sublimatedware/ILDA-Spec-Laser-Projector--Legacy-/Picture of Entire System.jpg

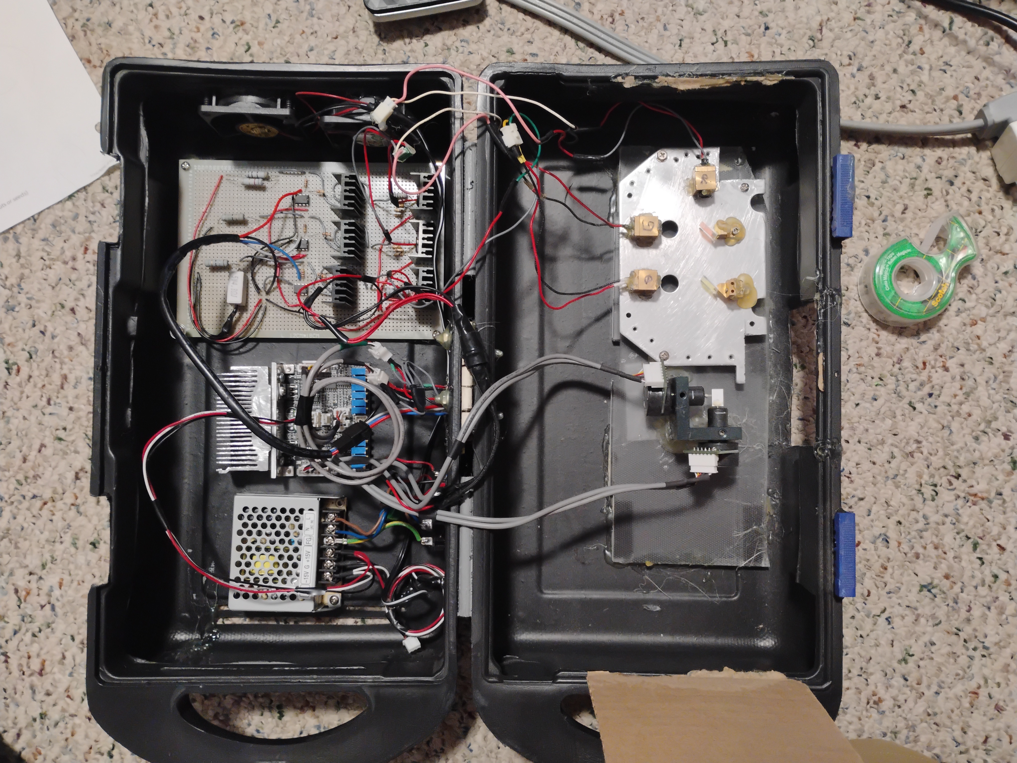
Picture of Entire System.jpg
