sublimatedware/ILDA-Spec-Laser-Projector--Legacy-/Demonstration Media/Deer.jpg

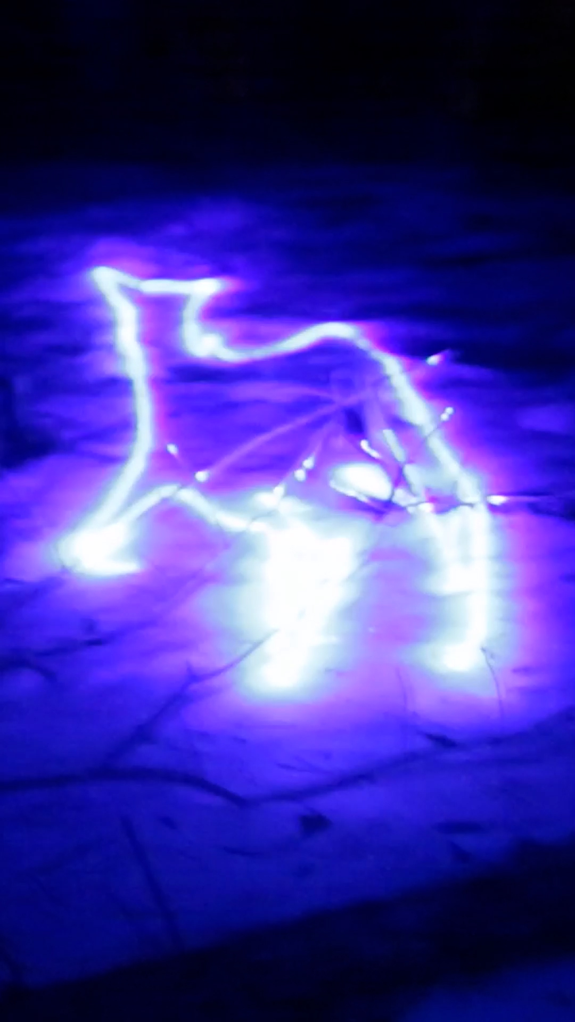
Demonstration Media/Deer.jpg
