sublimatedware/ILDA-Spec-Laser-Projector--Legacy-/Demonstration Media/IIlluminating DJ.jpg

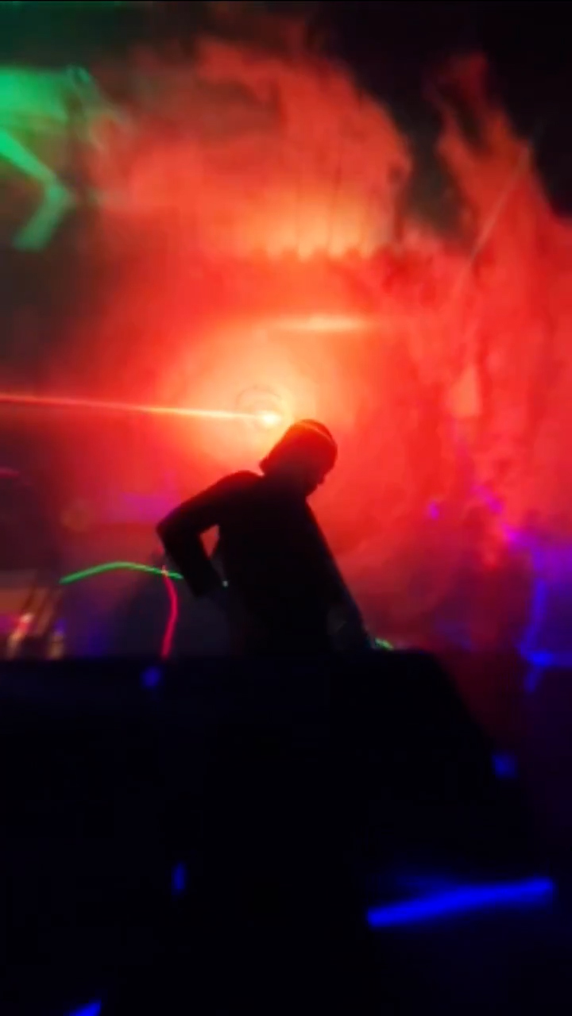
Demonstration Media/IIlluminating DJ.jpg
