sublimatedware/ILDA-Spec-Laser-Projector--Legacy-/Demonstration Media/Immersion in Light.jpg

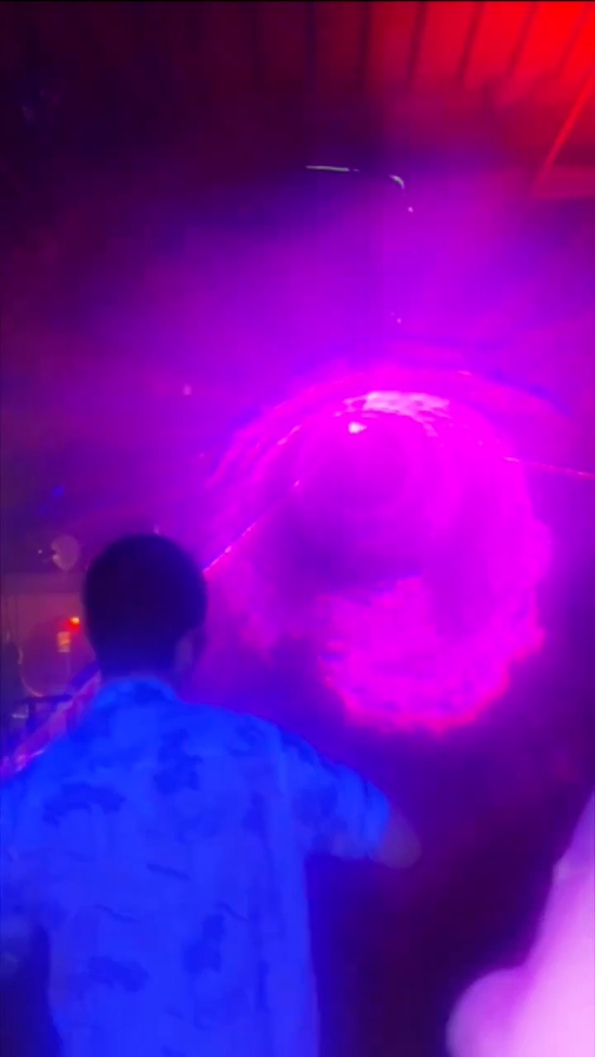
Demonstration Media/Immersion in Light.jpg
