sublimatedware/ILDA-Spec-Laser-Projector--Legacy-/Demonstration Media/Laser at Party 2.jpg

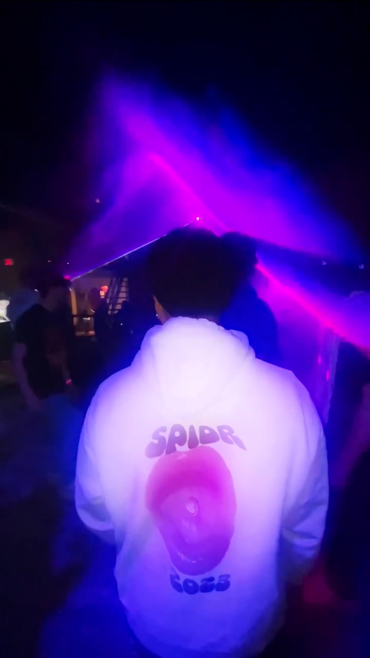
Demonstration Media/Laser at Party 2.jpg
