sublimatedware/ILDA-Spec-Laser-Projector--Legacy-/Demonstration Media/Laser at Party.jpg

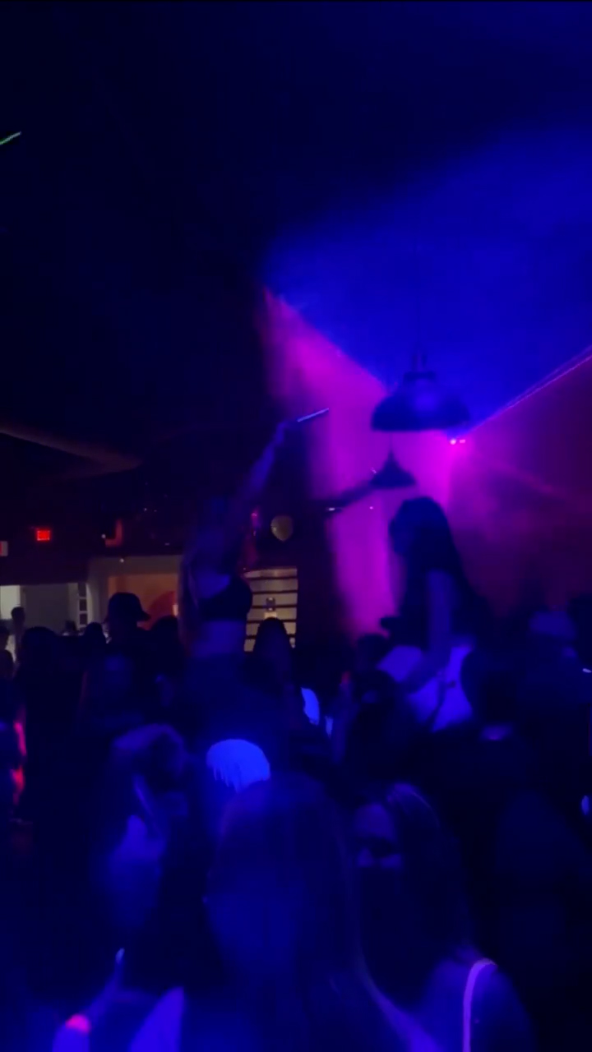
Demonstration Media/Laser at Party.jpg
