sublimatedware/ILDA-Spec-Laser-Projector--Legacy-/Retroactive schematic.png

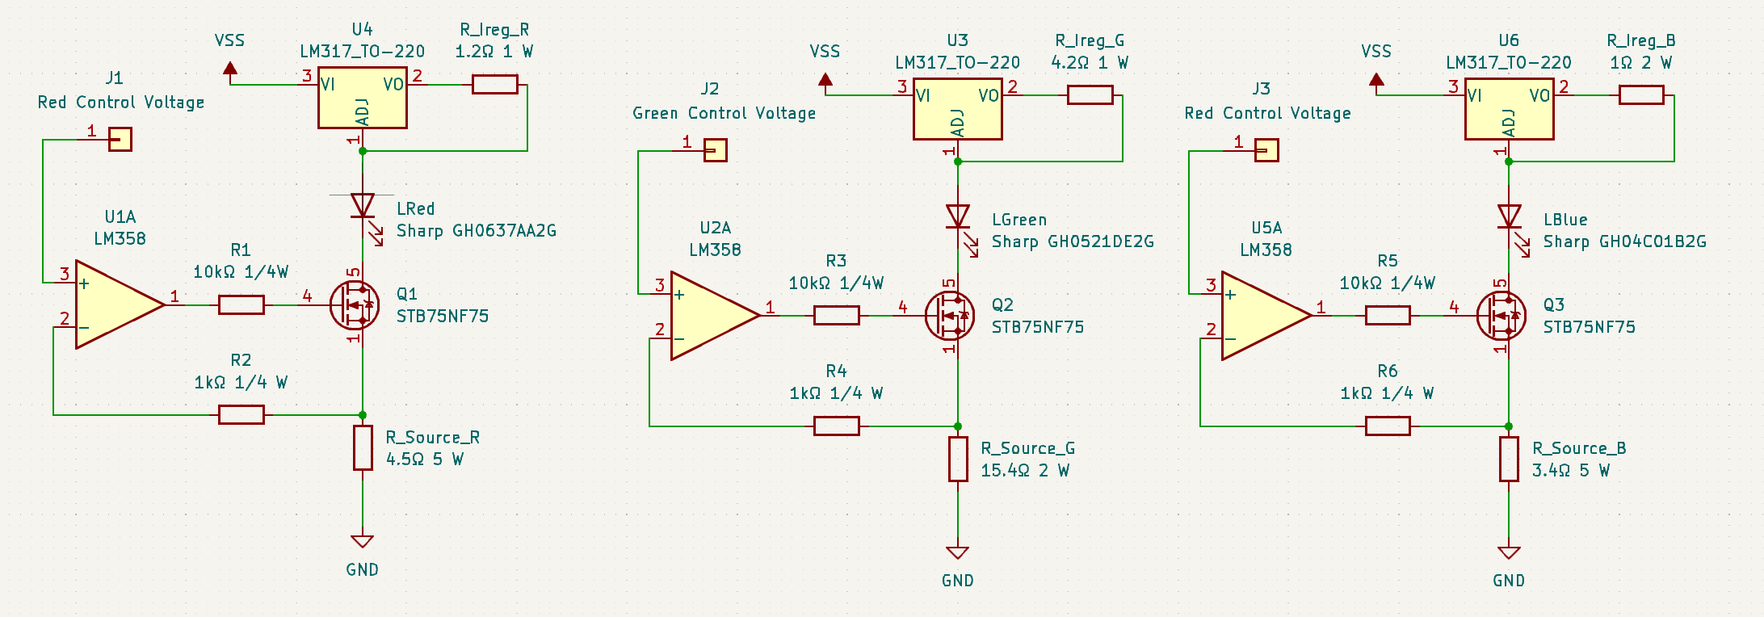
Retroactive schematic.png
