sublimatedware/ILDA-Spec-Laser-Projector--Legacy-/retroactive schematic.kicad_sch

## KiCad design retroactive schematic.kicad_sch (2026-03-03)

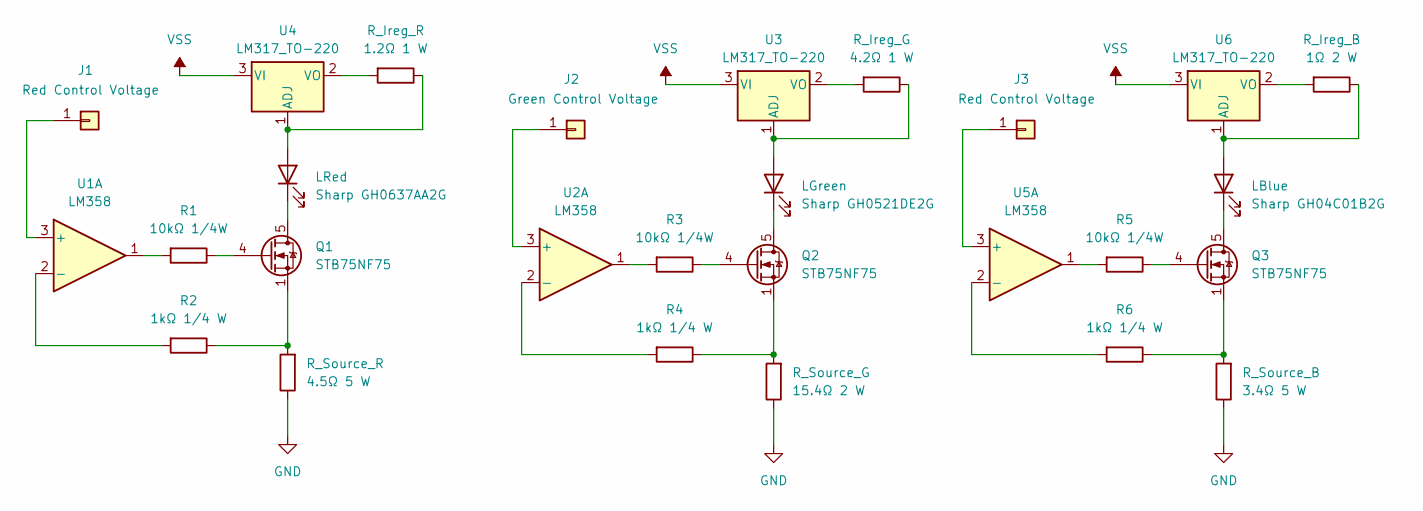
[picture p8: schematic retroactive schematic.kicad_sch]

Parts:
J1, J3: Red Control Voltage
J2: Green Control Voltage
LBlue: Sharp GH04C01B2G
LGreen: Sharp GH0521DE2G
LRed: Sharp GH0637AA2G
Q1, Q2, Q3: STB75NF75; TDSON-8-1
R1, R3, R5: 10kΩ 1/4W
R2, R4, R6: 1kΩ 1/4 W
R_Ireg_B: 1Ω 2 W
R_Ireg_G: 4.2Ω 1 W
R_Ireg_R: 1.2Ω 1 W
R_Source_B: 3.4Ω 5 W
R_Source_G: 15.4Ω 2 W
R_Source_R: 4.5Ω 5 W
U1, U2, U5: LM358
U3, U4, U6: LM317_TO-220; TO-220-3_Vertical

Connections:
GND: R_Source_B.1, R_Source_G.1, R_Source_R.1
unnamed: J1.1, U1.3 (+)
unnamed: J2.1, U2.3 (+)
unnamed: J3.1, U5.3 (+)
unnamed: LBlue.1 (K), Q3.5 (D)
unnamed: LBlue.2 (A), R_Ireg_B.1, U6.1 (ADJ)
unnamed: LGreen.1 (K), Q2.5 (D)
unnamed: LGreen.2 (A), R_Ireg_G.1, U3.1 (ADJ)
unnamed: LRed.1 (K), Q1.5 (D)
unnamed: LRed.2 (A), R_Ireg_R.1, U4.1 (ADJ)
unnamed: Q1.1 (S), Q1.2 (S), Q1.3 (S), R2.1, R_Source_R.2
unnamed: Q1.4 (G), R1.1
unnamed: Q2.1 (S), Q2.2 (S), Q2.3 (S), R4.1, R_Source_G.2
unnamed: Q2.4 (G), R3.1
unnamed: Q3.1 (S), Q3.2 (S), Q3.3 (S), R6.1, R_Source_B.2
unnamed: Q3.4 (G), R5.1
unnamed: R1.2, U1.1
unnamed: R2.2, U1.2 (-)
unnamed: R3.2, U2.1
unnamed: R4.2, U2.2 (-)
unnamed: R5.2, U5.1
unnamed: R6.2, U5.2 (-)
unnamed: R_Ireg_B.2, U6.2 (VO)
unnamed: R_Ireg_G.2, U3.2 (VO)
unnamed: R_Ireg_R.2, U4.2 (VO)
VSS: U3.3 (VI), U4.3 (VI), U6.3 (VI)
