sublimatedware/ILDA-Spec-Laser-Projector--Legacy-/calibration/Calibration screeshot.png

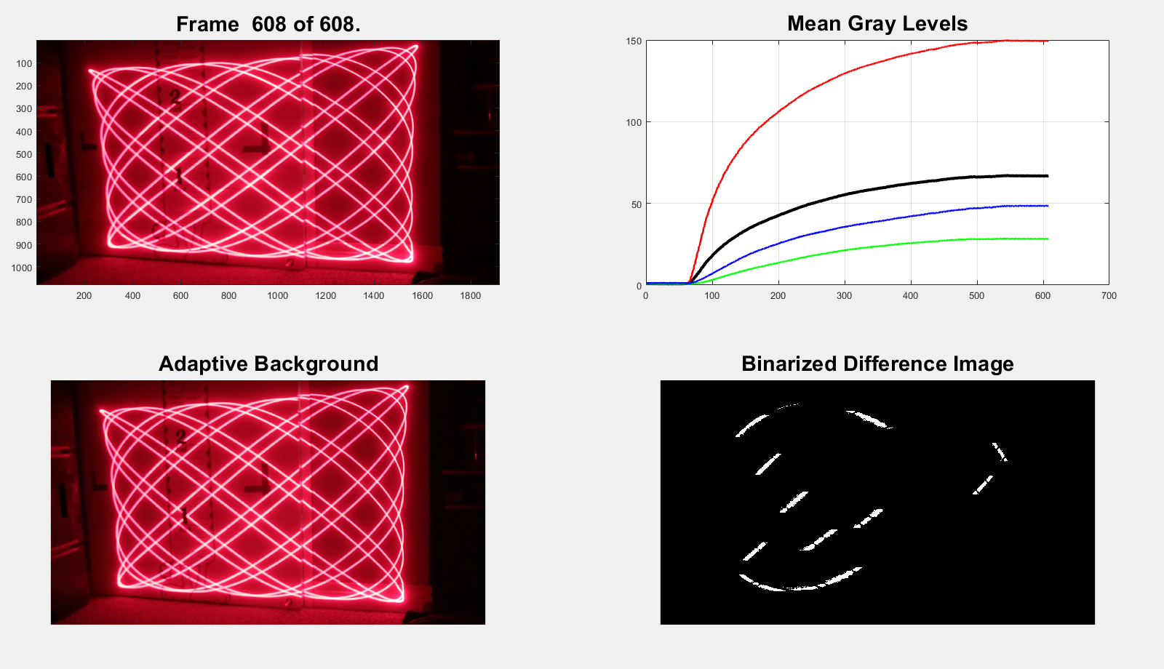
calibration/Calibration screeshot.png
