sublimatedware/ILDA-Spec-Laser-Projector--Legacy-/(commit log)

2026-03-03 Enhance README with detailed project information
    Expanded project description and added details about device calibration and performance.
2026-03-03 Delete calibration/Blue Normalized Raw Lut 2024.csv
    retroactively uploading project documents
    [Blue Normalized Raw Lut 2024.csv]
2026-03-03 Add files via upload
    retroactive upload of appropriate calibration files
    [Green Normalized Inverse Lut 2024.csv, Red Normalized Inverse Lut 2024.csv]
2026-03-03 Add calibration instructions to README
    Added detailed calibration instructions for the laser amplifier.
